alkaliu/Dual_Channel_CAN_Logger/sch/EASYEDA_MODELS/TMS-102-53-L-S.stp

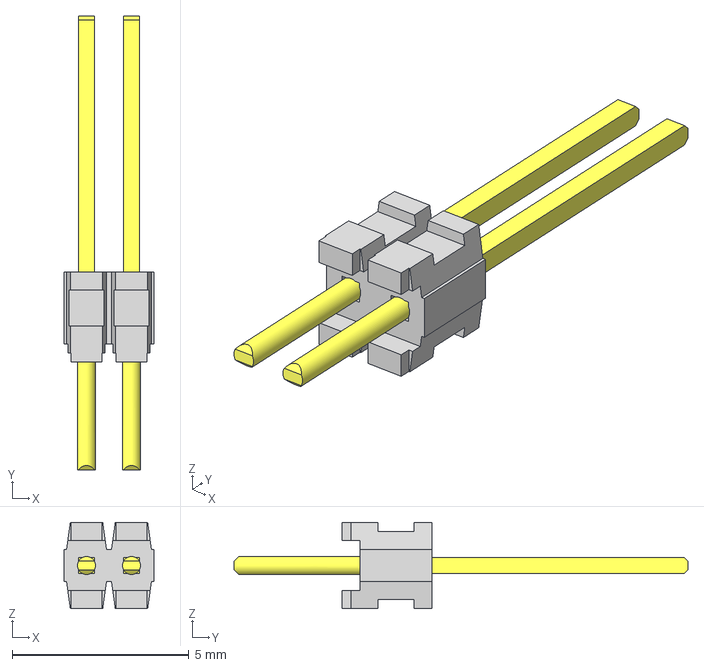
[picture p1: CAD file, 2025-11-24]
sch/EASYEDA_MODELS/TMS-102-53-L-S.stp
2.54 x 12.8 x 2.44 mm
TMS-102-S_header
T-1M6-02-53-S
