alkaliu/Dual_Channel_CAN_Logger/sch/EASYEDA_MODELS/FTSH-103-01-L-DV-TR--3DModel-STEP-56544.STEP

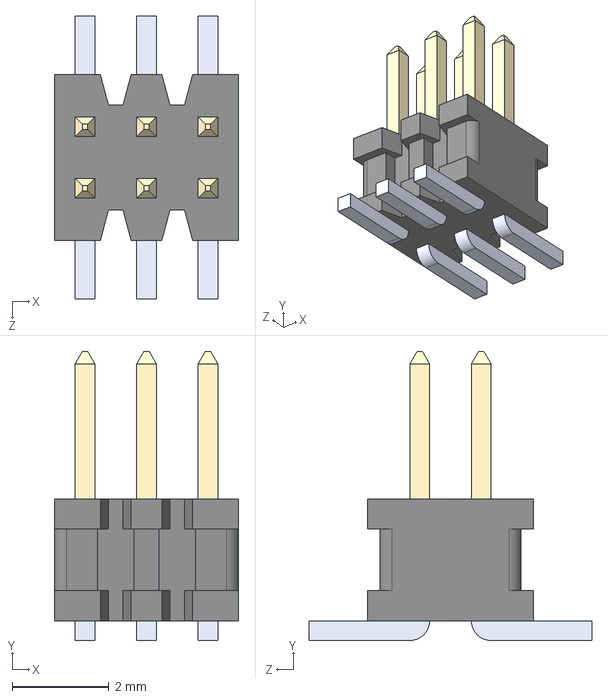
[picture p2: CAD file, 2025-11-24]
sch/EASYEDA_MODELS/FTSH-103-01-L-DV-TR--3DModel-STEP-56544.STEP
3.81 x 5.97 x 5.84 mm
