alkaliu/Dual_Channel_CAN_Logger/sch/EASYEDA_MODELS/62200213421_2pin_1_27mmJumper.step

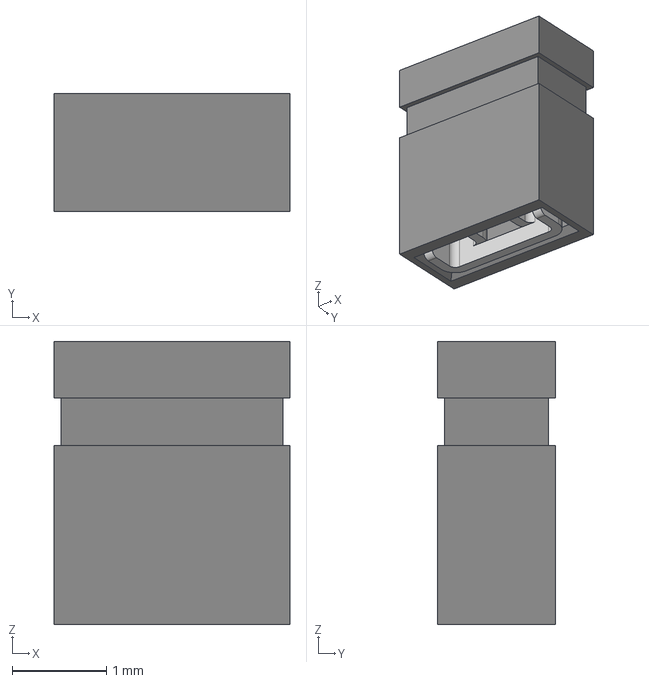
[picture p3: CAD file, 2025-11-24]
sch/EASYEDA_MODELS/62200213421_2pin_1_27mmJumper.step
2.50 x 1.25 x 3.00 mm
