alkaliu/Dual_Channel_CAN_Logger/sch/v1.1_pre/canlogger_sch_1.1_pre.pdf

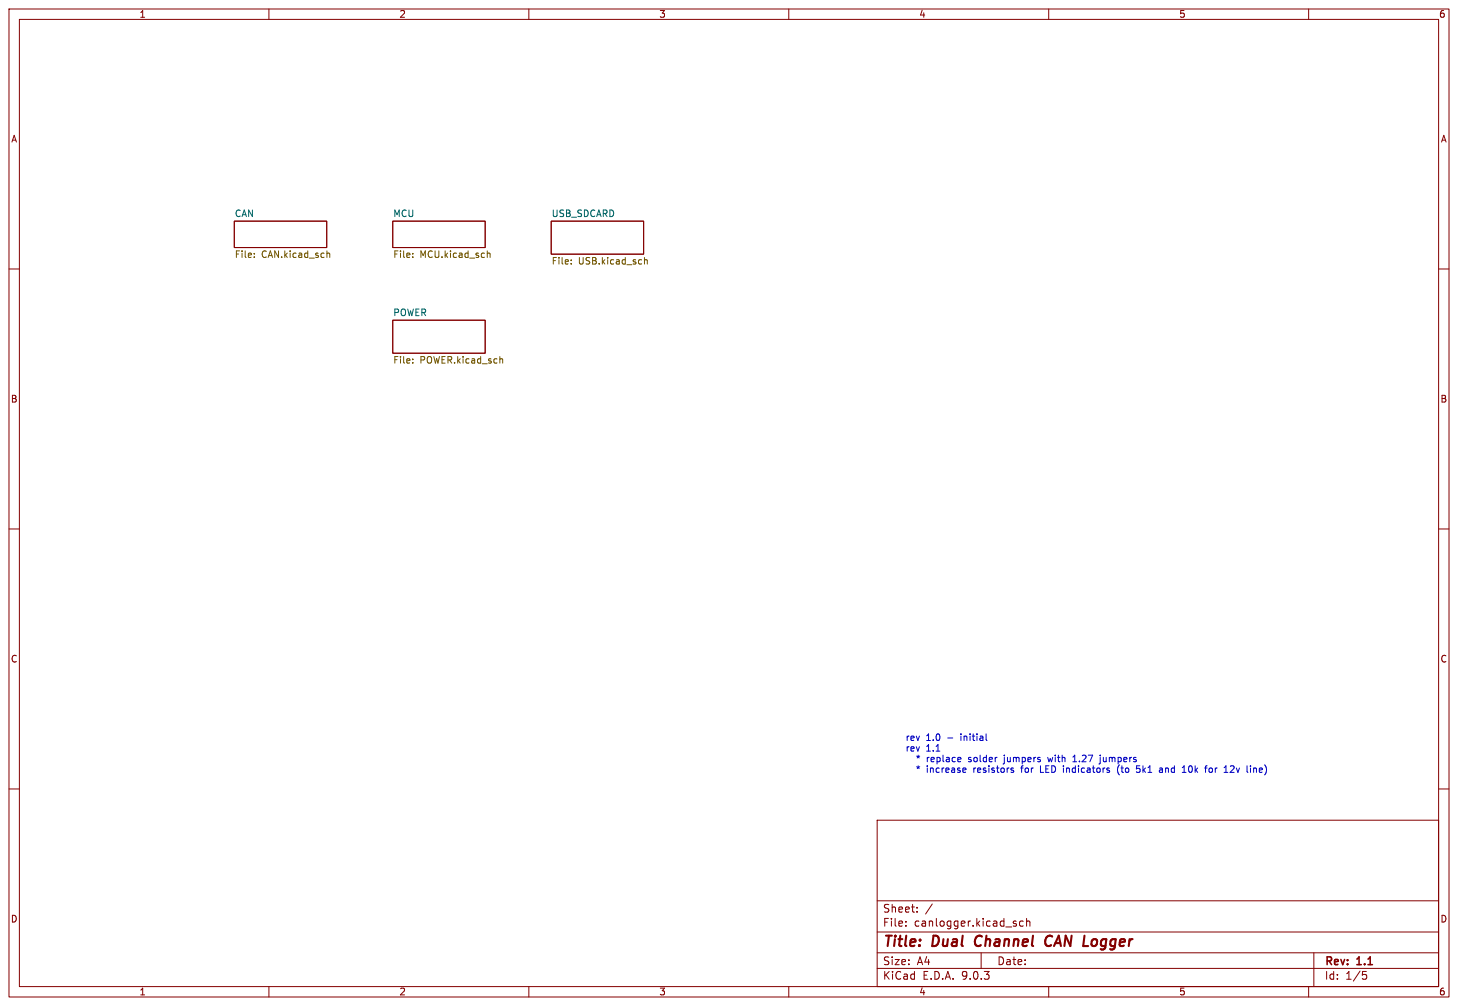
[picture p4: page 1]

* replace solder jumpers with 1.27 jumpers

Id: 1/5 Title: Dual Channel CAN Logger File: canlogger.kicad_sch Sheet: /

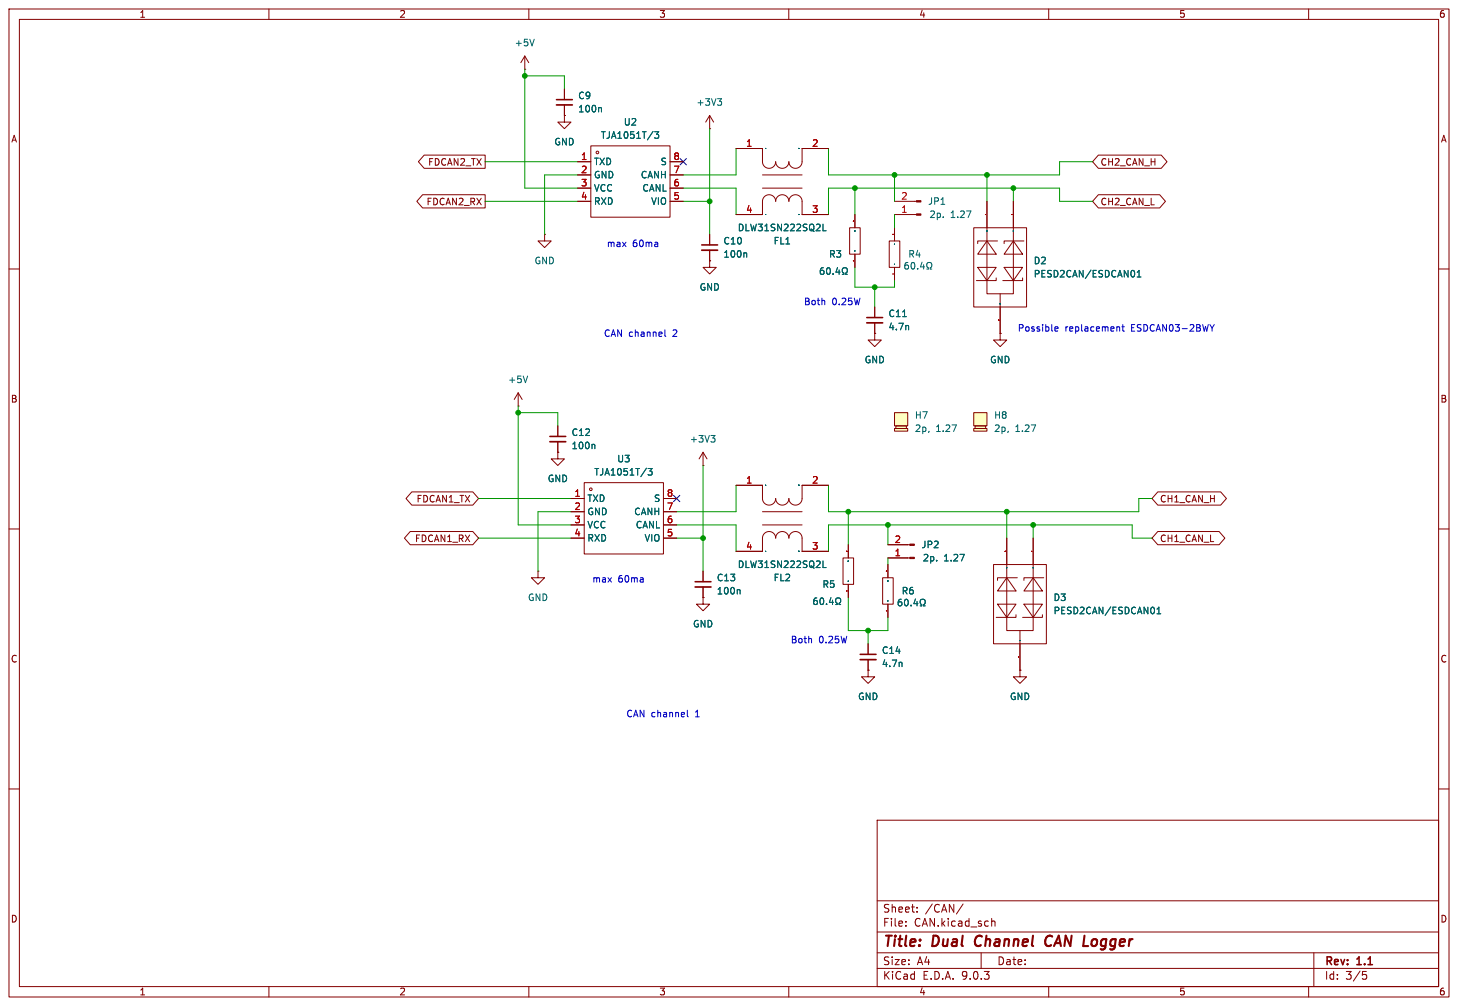
[picture p5: page 2]

Id: 3/5 Title: Dual Channel CAN Logger File: CAN.kicad_sch Sheet: /CAN/

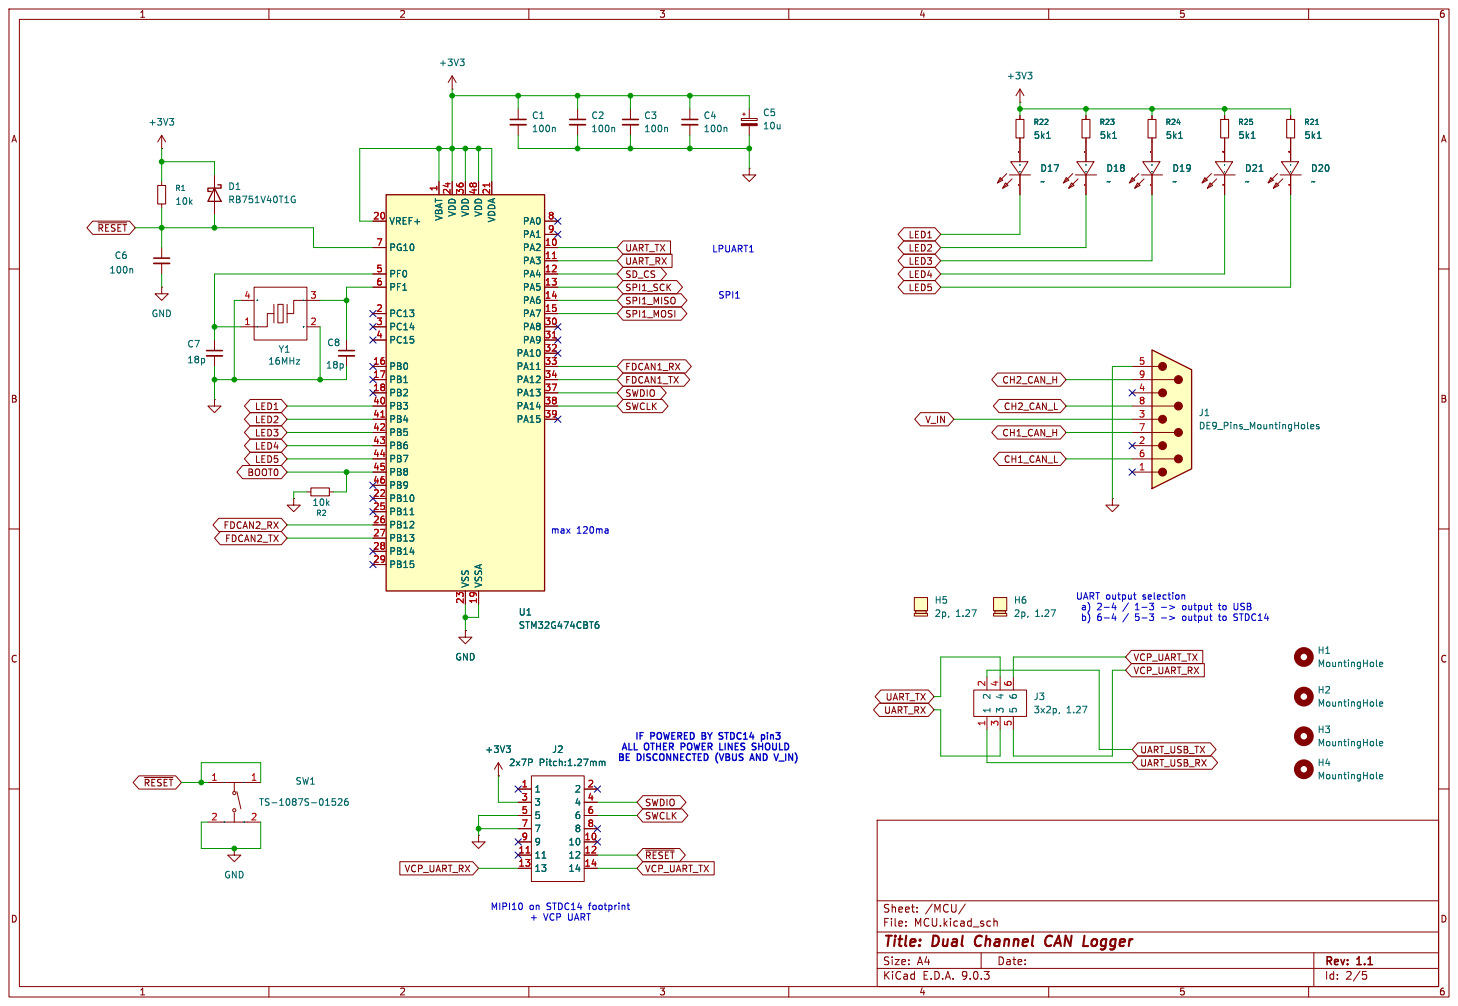
[picture p6: page 3]

1 VDD 24 VDD 36 VSS 23 VDD 48 VSSA 19 VDDA 21 PA0 8 PA1 9 PA2 10 PA3 11 PA4 12 PA5 13 PA6 14 PA7 15 PA8 30 PA9 31 PA10 32 PA11 33 PA12 34 PA13 37 PA14 38 PA15 39 U1STM32G474CBT6

1 VDD 24 VDD 36 VSS 23 VDD 48 VSSA 19 VDDA 21 PA0 8 PA1 9 PA2 10 PA3 11 PA4 12 PA5 13 PA6 14 PA7 15 PA8 30 PA9 31 PA10 32 PA11 33 PA12 34 PA13 37 PA14 38 PA15 39 +3V3 J2

BE DISCONNECTED (VBUS AND V_IN) GND

IF POWERED BY STDC14 pin3 ALL OTHER POWER LINES SHOULD

Id: 2/5 Title: Dual Channel CAN Logger File: MCU.kicad_sch Sheet: /MCU/

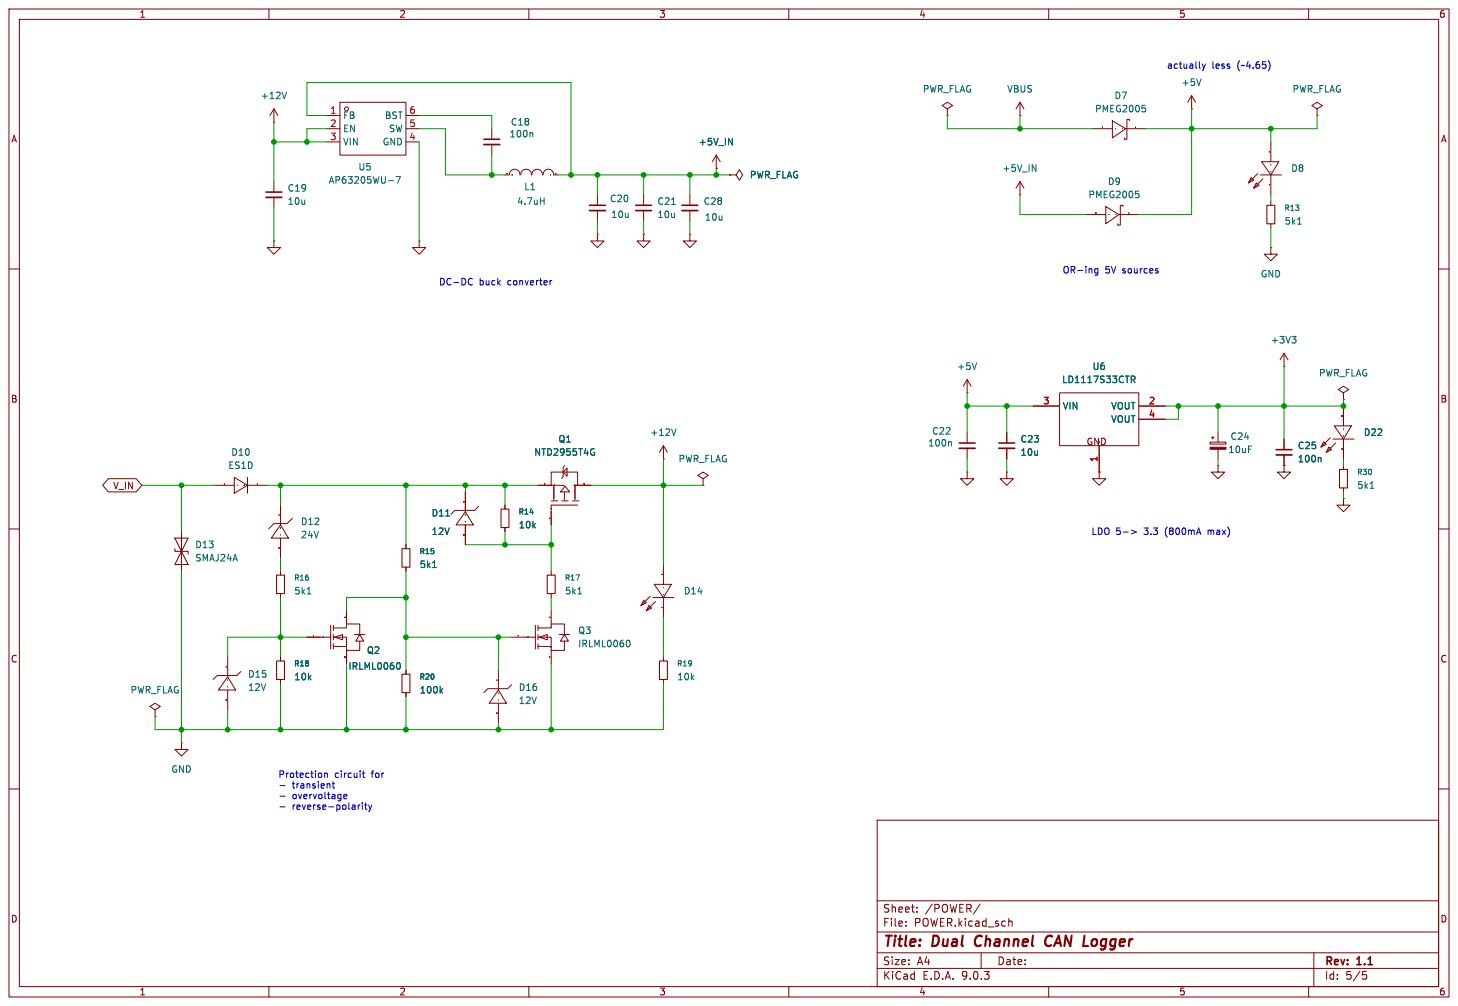
[picture p7: page 4]

Id: 5/5 Title: Dual Channel CAN Logger File: POWER.kicad_sch Sheet: /POWER/

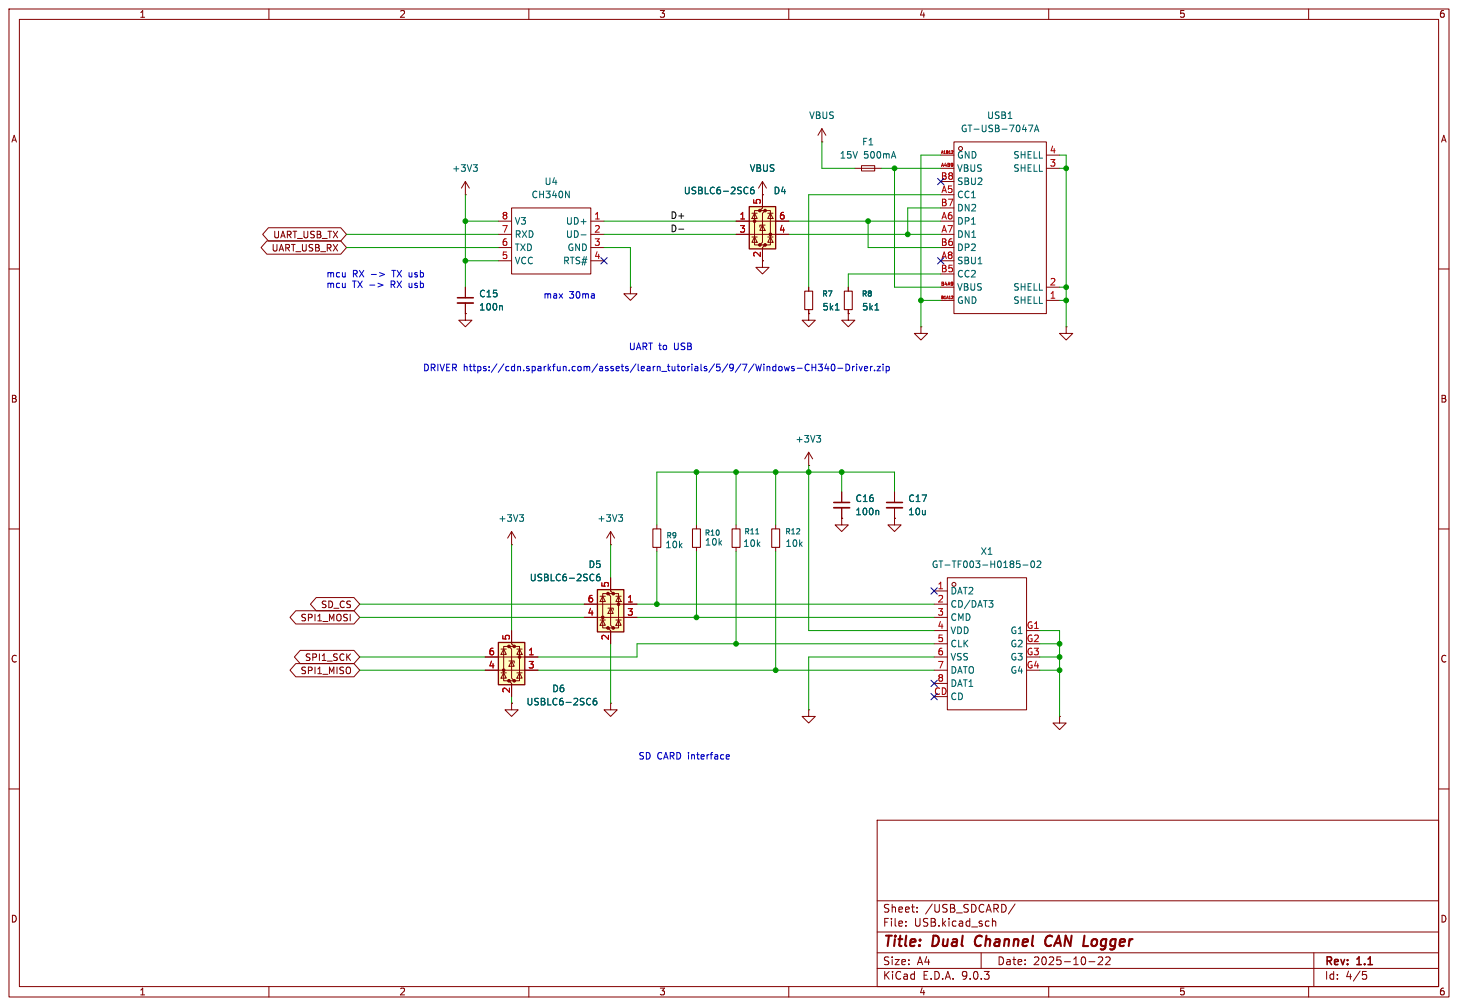
[picture p8: page 5]

Id: 4/5 Title: Dual Channel CAN Logger File: USB.kicad_sch Sheet: /USB_SDCARD/
