alkaliu/Dual_Channel_CAN_Logger/(notices)

Notices in the files:
sch/EASYEDA_MODELS/TMS-102-53-L-S.stp:
author */ ('License CC BY-ND 4.0'),
